jakob-ledermann/qdn-spool-holder/Assembly.FCStd

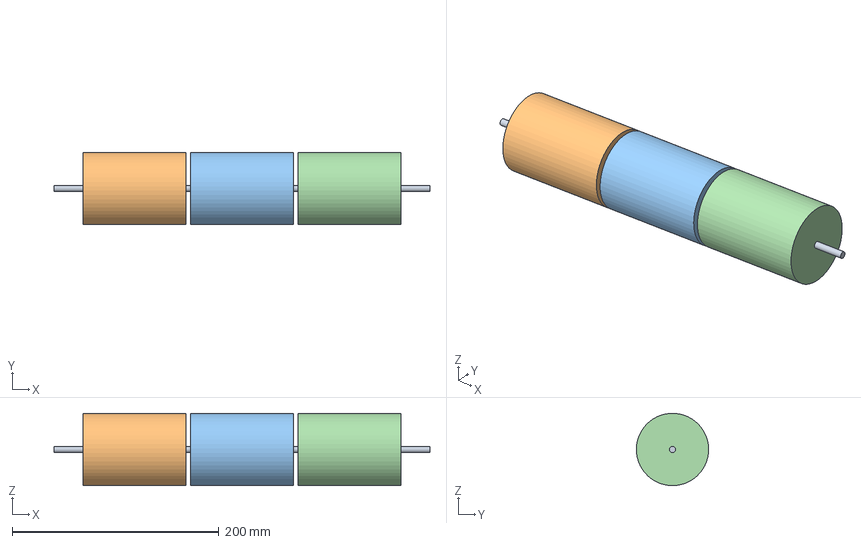
[picture p1: CAD file, 2026-09-09]
Assembly.FCStd
364.0 x 70.0 x 69.9 mm
Rod_M6
Spool1
Spool2
Spool3
