jakob-ledermann/qdn-spool-holder/SpoolHolder.FCStd

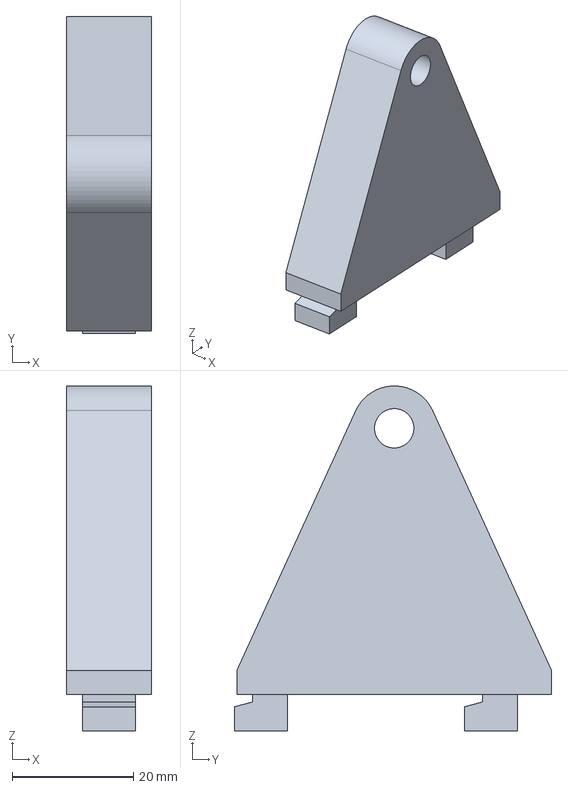
[picture p2: CAD file, 2026-09-09]
SpoolHolder.FCStd
14.0 x 52.4 x 57.0 mm
