jakob-ledermann/qdn-spool-holder/Wall_QDN.FCStd

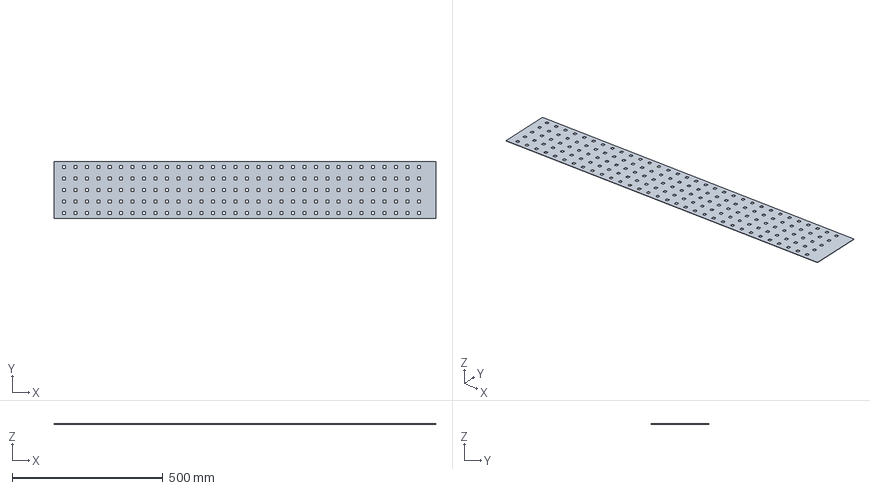
[picture p3: CAD file, 2026-09-06]
Wall_QDN.FCStd
1268.0 x 190.0 x 1.20 mm
