jakob-ledermann/qdn-spool-holder/(list of files, cad)

Other CAD files:
exports/Assembly.stl
exports/SpoolHolder.3mf
exports/SpoolHolder.stl
