jakob-ledermann/qdn-spool-holder/(commit log)

2026-09-06 Insert Initial files
    [Assembly.FCStd, SpoolHolder.FCStd, Wall_QDN.FCStd]
2026-09-06 Fix assembly + manual export
    [Assembly.FCStd, SpoolHolder.FCStd, SpoolHolder.stl]
2026-09-06 Add headless export + CI workflow
    - export_qdn.py: SpoolHolder.stl/.3mf + Assembly.glb/.html into exports/
    (built-in GLB writer + stock BIM WebGL template; FreeCAD headless
    glTF/GLB export is empty and importWebGL segfaults freecadcmd)
    - .github/workflows/export.yml: micromamba + conda-forge freecad=1.1.3,
    verify gate -> export -> commit exports/ back -> artifact
    - retire hand-made root-level STL/glTF/HTML exports (now in exports/)
    - verify_fixture.py / shell.nix: cwd fallback + export command
    [SpoolHolder.3mf, SpoolHolder.stl]
2026-09-06 chore(exports): regenerate prints + preview
    [SpoolHolder.3mf]
2026-09-06 export: make 3MF bytes reproducible (fixed zip timestamps)
    [SpoolHolder.3mf]
2026-09-07 Create static.yml
    Should publish the assembly as a github page
2026-09-09 verify: invariant-based checks + correctly seat brackets on wall grid
    - verify_fixture.py rewritten around V0-V5 invariants (no overlap,
    insertion clearance >= 0.4 mm at the sheet plane, hook tuck >= 2 mm,
    wrap >= 1.5 mm + cam-out autonomy <= 15 deg, plate coverage/centering,
    0.6.5 through-bore along X threaded by the rod).
    - Fix grid_rows_cols axis swap (hole rows/cols measured from transverse
    face centres) and enlarge V1/V3 windows so readings are not clipped;
    bearing face selection now requires a downward -Y outward normal.
    - Re-seat Bracket1/2 on the measured 38 mm hole grid (cols 413.05/755.05,
    rows -133/-95): X +1.2, Y +2.6 from the previous -2,-2 nudge; rod/spools
    follow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
    [Assembly.FCStd, Assembly.stl, SpoolHolder.3mf, SpoolHolder.FCStd, SpoolHolder.stl]
2026-09-09 docs: de-brand wall-system references (trademark-safe)
    Describe the perforated panel by its functional dimensions (38 mm pitch,
    10 mm holes) instead of the commercial system name/product code; clarify
    that 'QDN' in this repo is the project codename only.
2026-09-10 ci: deploy exports to GitHub Pages from the export workflow
    The UI-created static.yml uploaded ./exports/, which had no index.html
    (404 at the Pages root) and redeploys only on real pushes/manual
    dispatch. Fold the Pages deploy (configure/upload/deploy-pages) into
    export.yml and have export_qdn.py also write exports/index.html so the
    site root is the assembly viewer.
    Static.yml is removed; one-time repo setting still required:
    Settings -> Pages -> Source = "GitHub Actions".
